massivebrains/battery-watchdog/Battery_Watchdog_Implementation_Plan.docx

# Battery Watchdog — Implementation Plan

Auto-restart system for the Growatt ABM 5.5L-A1-H master battery · v1.1 · updated July 2026

# 1. The problem and the approach

The master battery on the Growatt inverter sometimes shuts itself off while grid power is on. When grid power later returns, the inverter has no battery, the house stays down, and the power button must be pressed by hand. This project is a non-invasive "watchdog" that watches the battery front panel and presses the button automatically.

Design principle: nothing is wired into the battery or inverter. Two light sensors read the panel LEDs, and a small servo motor physically presses the power button — exactly what you do manually today. If the watchdog is ever removed, the system is untouched.

Changes in v1.1: the ALM sensor was dropped (it never influenced the press decision — two sensors are enough and are easier to mount), and alerts now go to your own server as a JSON webhook instead of directly to Telegram, so notification routing can change without re-flashing the device.

# 2. How the watchdog behaves

Every 2 seconds the ESP32 reads both light sensors. The decision logic:

RUN | SOC LED | What it means | Action
ON | any | Battery running normally | Do nothing
OFF | ON | Battery shutting down | Wait (alert once); do NOT press yet
OFF | OFF | Battery fully off | After 16 s of stable "all off": press the button once

After a press, the watchdog waits 45 seconds (the battery boots: ALM+RUN light up, ALM turns off after ~3 s, the inverter reconnects), then checks RUN:

- RUN back on → "wake_success" alert. Back to monitoring.
- RUN still off → "wake_failed" alert, wait 5 minutes, then it may try again.

## Safety limits

- Maximum 3 presses per hour. If the battery keeps dying, the watchdog locks itself out and alerts you instead of fighting a battery that is protecting itself. It re-arms automatically when it sees the battery running again.
- 16-second debounce before any press, so a brief LED flicker never triggers the servo.
- The servo detaches after each press — it cannot jam against or hold the button.

## Why the leftmost SOC LED

The SOC (State of Charge) bar fills left to right. At low charge only the leftmost LED remains, so it is the last one to turn off — the single most reliable indicator that the SOC display is completely dark.

## Alerts

Every event is sent as an HTTPS request to your server, which handles the actual notification (Telegram, WhatsApp, etc.):

POST https://vast-comet-94.webhook.cool/ with JSON body {"event": "<code>", "message": "<human-readable text>"}

Event code | Meaning
started | Watchdog booted (message says DRY RUN or ACTIVE mode)
shutdown_pending | RUN went off while SOC still lit — shutdown in progress, waiting
pressing | Battery fully off; pressing the button now
wake_success | Battery came back after the press
wake_failed | Press did not bring the battery back; retrying in 5 minutes
locked_out | Press limit (3/hour) reached; watchdog stopped for safety
rearmed | Battery seen running again after lockout; watchdog re-armed
run_restored | RUN light came back on (any reason)

# 3. Hardware and wiring

Part | Qty | Role
ESP32 DevKit (38-pin, CP2102 USB chip) | 1 | Brain: reads sensors, drives servo, sends webhook alerts
LM393 LDR module | 2 | One over RUN, one over the leftmost SOC LED (analog AO pin used)
SG90 servo + horn | 1 | Presses the power button
50 cm servo extension | 1 | Keeps the ESP32 away from the button area
Jumper (Dupont) wires | ~10 | Sensor and servo connections
Heat shrink + black tape | — | Light shrouds around each sensor + insulating the splice
3M foam tape, zip ties | — | Mounting sensors and servo
Project enclosure | 1 | Houses the ESP32
USB charger 5V 2A + cable | 1 | Powers ESP32 and servo together

## Pin map (as built)

Connection | ESP32 pin | Note
LDR 1 (RUN) — AO pin | GPIO 34 | ADC1, input-only pin
LDR 2 (SOC leftmost) — AO pin | GPIO 35 | ADC1, input-only pin
Both LDR VCC pins | 3V3 | Joined by a twisted-wire splice (insulated with heat shrink)
Each LDR GND | GND | The board has 3 GND pins — each sensor uses its own
Servo signal (orange) | GPIO 18 | Via 50 cm extension
Servo power (red) | 5V | The pin labeled 5V on this board (a.k.a. VIN on others)
Servo ground (brown) | GND | Any GND pin

Why these pins: only GPIO 32-39 (ADC1) can do analog reading while Wi-Fi is active — other analog pins silently fail. The AO pin is used instead of DO so thresholds live in software rather than in the module's tiny potentiometer.

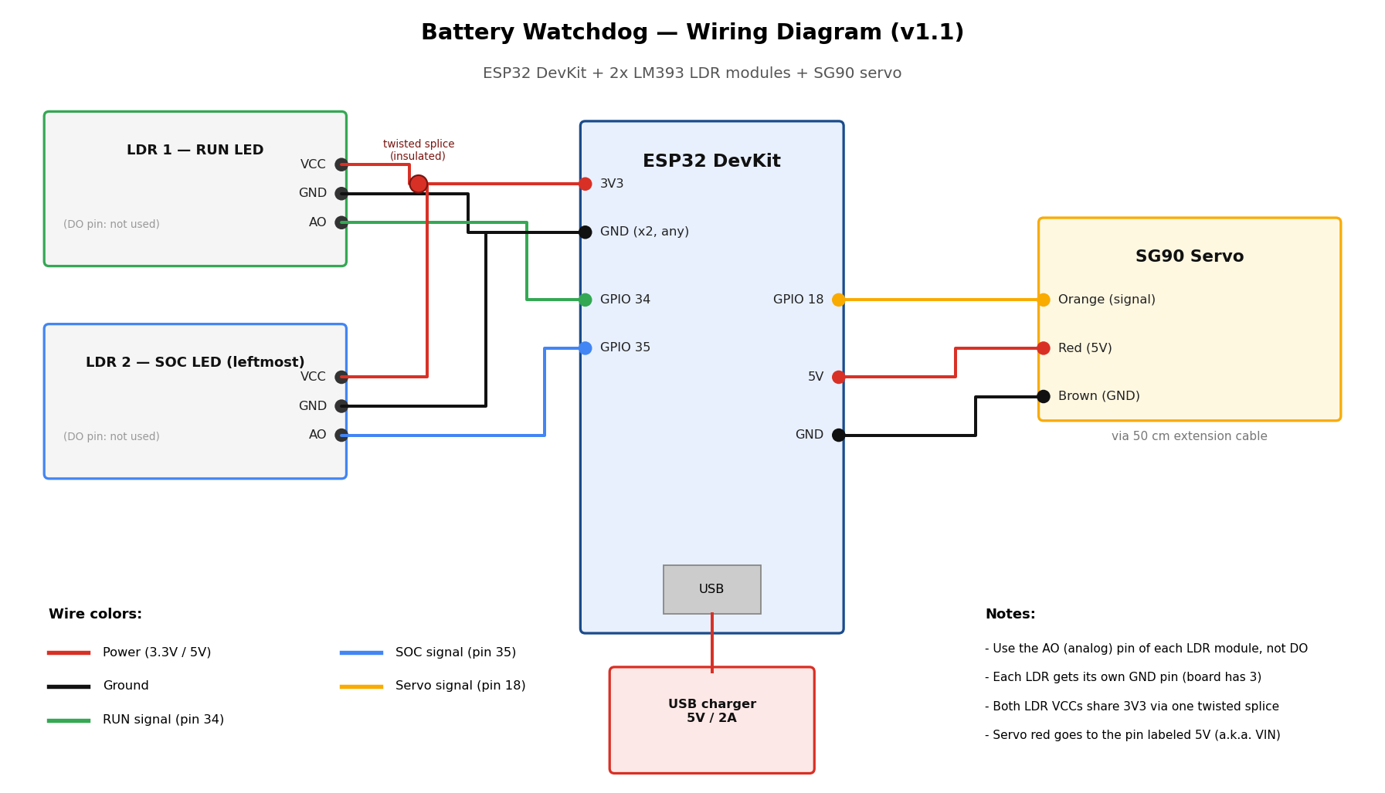
[picture p1: figure]

Full-size image: wiring_diagram.png (same folder)

# 4. Calibration results (as measured)

Item | Value
Sensor reading, LED on | below 2000 (bright light reads near 0)
Sensor reading, LED off / covered | 3600 - 4000
LED_THRESHOLD in code | 2800 (below = LED on)
Servo rest angle | 0 degrees (arm clear of button)
Servo press angle | 32 degrees (button fully pressed)
Press duration | 0.6 s press-and-release

Note: the sensor modules read LOWER with more light. The two onboard green LEDs on each module cannot be disabled — cover them with black tape; the DO status LED can also be switched off by turning the blue potentiometer.

# 5. Mechanical mounting

## Light sensors

1. Slide heat shrink (or a black tape tube) over each sensor's bulb so light can only enter from the front.
2. With the Serial Monitor open, hold each sensor over its LED and slide it around until the reading responds strongly, then stick it down with foam tape: sensor on pin 34 over RUN, sensor on pin 35 over the leftmost SOC LED.
3. The sensors must not cover the power button or air vents.

## Servo

1. The servo range is 0-180 only (no negative angles). If the geometry does not fit, pop the horn off the splined shaft and re-seat it rotated — move the arm to fit the range.
2. Foam pad on the horn tip; mount the servo body rock-solid beside the button with foam tape + zip-tie anchor.
3. After mounting, re-check the rest/press angles in calibrate mode (mounting can shift geometry a few degrees).

# 6. Software

Firmware: battery_watchdog/battery_watchdog.ino (same folder, in git). Three modes controlled by the MODE define at the top:

Mode | What it does | When
MODE_CALIBRATE | Streams live sensor values; type an angle 0-180 + Enter in the Serial Monitor to jog the servo | Finding thresholds and servo angles
MODE_DRY_RUN | Full logic and alerts, but the servo never moves — logs "would press" | Run 2-3 days to trust the detection
MODE_ACTIVE | The real thing | After a clean dry run

## Toolchain (as installed)

- Arduino IDE + board package "esp32 by Espressif Systems" (v3.3.x). Board: "ESP32 Dev Module".
- Library: ESP32Servo (by Kevin Harrington). The standard Servo library does not work on ESP32.
- Windows driver for the board's CP2102 USB chip: Silicon Labs "CP210x Universal Windows Driver". The board then appears as a COM port.
- Serial Monitor at 115200 baud.
- Wi-Fi: 2.4 GHz networks only — the ESP32 cannot see 5 GHz. If connection fails, try the other band's network name.

# 7. Status & remaining steps

Phase | Status
0. Bench test (sensors respond, servo jogs) | DONE
1. Sensor calibration (thresholds set: 2800) | DONE
2. Servo angles found (rest 0, press 32) | DONE
3. Mount sensors + servo permanently, re-verify readings/angles | TO DO
4. Dry run 2-3 days (MODE_DRY_RUN, watch webhook events) | TO DO
5. Go live (MODE_ACTIVE) | TO DO

For permanent installation: the ESP32's USB charger should plug into an inverter-backed socket near the battery, and Wi-Fi must reach that spot (alerts need it; the button press itself works without internet).

# 8. Honest limitations and the real fix

- This is a workaround, not a repair. The master battery shutting down is the underlying fault. Keep pressing Growatt / the distributor: likely suspects are the inter-battery comm cable, DIP switch addressing between master and slave, or battery BMS firmware.
- If the battery is shutting down to protect itself, waking it repeatedly is not ideal — that is why the watchdog stops after 3 attempts per hour and alerts you instead.
- When grid and battery are both down, the router may be off too, so alerts can be delayed until power returns — the press itself still works as long as the ESP32 has power.
