massivebrains/battery-watchdog/(commit log)

2026-07-26 feat: Updated to Battery
2026-07-31 feat: ;update led thresold
